burgrp/din-rs485-wifi/doc/BMS.Protocol.V2.5.CHINESE.pdf

# 监控平台与BMS通讯协议

# 版本信息

版本 | 日期 | 描述 | 作者
| V20191124 | 初稿
| V20200325 | 更新一些描述信息,更改0xA10改为0XD2,专用充电器开关指 令
| V20200325 | 确定传送的数据波特率115200
| V20200329 | 更新优化指令表，重新定义数据标识码
| V20200329 | 增加一次性读取全部数据指令.
| V20200427 | 进行写ID 写出厂日期进行说明
| V20200429 | 添加0xb7地址 软件版本号
| V20200429 | 对0x8b 0x8c 地址详细描述
| V20200508 | 对0x84地址进行优化 单位：0.1A修改成0.01A
| V20200512 | 0x81地址名称进行重新定义 电池箱内温度
| V20200512 | 把0xA0 0xA1 名称重新定义
| V20200512 | 对0x8B地址 报警位添加
| V20200526 | 添加重启系统标识0xBB
| V20200615 | 添加0xB8标识 版本变更 V2.0
V20200713 | 添加0xBC标识 恢复出厂初始化 版本变更 V2.1

添加309故障信息

| V20200825 | 添加0xBE 0xBF
V2.4 | 20201204 | 增加0xC0 重新定义电流字段数据 | echo
V2.5 | 20201217 | 增加必要字段上报说明 | echo

目录

1 概述
本规约定义了监控平台与电池终端之间的通讯协议，定义了报文格式和传输方式，通讯方式等。

## 2 引用标准

通信使用2G的GPRS中TCP传输, 4G中GAT1,SOCKET接口方式,RS232TTL串口,内容自定义通信格式,波特率115200.

## 3 网络拓扑

本协议是BMS,GPS,蓝牙端,PC上位机与终端点对点或总线的方式.

## 4 规约内容 4.1 通讯规则

通讯过程中设备有主动上报帧也有被动响应帧，具体参考通讯数据格式。每包数所间隔最少100MS,最长回复包不超过5S, 定时广播,如果休眠中,则于控制端发送激活信息,激活BMS,再进行通信.

## 4.2 帧格式

帧是传送信息的基本单元。其中包括起始符，长度，命令字，传输类型，信息域、结束标识，校验和。具体格式如表1 所示。数据单元中如果没有强制说明的内容低字节在右,高字节在左。发送是先发高位再发低位.
表1 帧格式
序号 | 帧单元 | 长度 | 备注
1 | STX | 2 | 起始帧：0x4E(78"N") 0x57(87"W")
2 | LENGTH | 2 | 帧长度
3 | BMS终端号 | 4 | 4字节ID
4 | 命令字 | 1 | 参考命令字说明,
5 | 帧来源 | 1 | 0.BMS,1.蓝牙,2.GPS,3,PC上位机
6 | 传输类型 | 1 | 0.读数据,1.应答帧 2.BMS主动上传
7 | 帧信息单元 | N | 信息域 BMS设置数据标识码
8 | 记录号 | 4 | 高1字节是随机码无意义(保留加密用)，低3字节是 记录序号
9 | 结束标识 | 1 | 0X68
10 | 校验和 | 4 | 累加校验和（高二字节用于CRC暂不启用填0，低二 字节用于累加校验）

## 4.2.1 帧起始符域

两个字节。第一个字节0x4e,第二个字节0x57。

## 4.2.2 长度域 L：两个字节，除去起始两个字符所有的数据字节包括校验和和长度域本身。

## 4.2.3 BMS终端号()

共四字节： FF FF FF FF 最高8位管理备用号，低24位是终端号 ，(最高一字节是保留默认00,低三字节是维一ID号)

## 4.2.4 命令字说明

一个字节，定义了本帧的传输功能。
命令码 | 命令项 | 备注
0x01 | 激活指令, | 当BMS休眠时,控制端要和BMS通信就要发先激活命令过来.收到 回复后再进行其它操作.
0X02 | 写指令

配置BMS参数指令,

0X03 | 读指令 | 读取BMS标识码数据,
0x05 | 对密码指令 | 要修改参数的时候,先发命令过正确之后才能改
0x06 | 读全部数据 | 一次性读完标识码表全部数据

## 4.2.5 帧来源说明

1个字节.相对于收发双方而言，0.BMS,1.蓝牙,2.GPS,3,PC上位机

## 4.2.6 传输类型

1个字节：0代表请求帧，1代表应答帧。2代表主动上报。 只要是先发起5-蓝牙,2-GPS,3-PC上位机，4-BMS先发起，回复都是用1。

## 4.2.7 记录号

## 高1个字节是随机码，低3个字节是记录码

## 4.2.8 结束码域

## 一个字节 0x68

## 4.2.9 校验码域

高二字节CRC16暂时不用,校验和从起始符到结束标识所有的数据累加和。

# 4.3 通讯数据格式 例： GPS读（全部、单个）数据参考

序号 | 帧单元 | 长度字节
1 | STX | 2 | 起始帧：0x4E(78"N") 0x57(87"W")
2 | LENGTH | 2 | 帧长度
3 | BMS终端号 | 4 | 4字节ID
4 | 命令字 | 1 | 参考命令写说明
5 | 帧来源 | 1 | 0.数据盒子,1.蓝牙,2.GPS,3,PC上位机
6 | 传输类型 | 1 | 0.读数据,1.应答帧 2.数据盒子主动上传
7 | 数据标识码 | 1 | 读单个数据参考(5.1表);读全部数据填0x00
8 | 记录号 | 4 | 高1字节是随机码无意义(保留加密用)，低3字节是记录序号
9 | 结束标识 | 1 | 0x68
10 | 校验和 | 4

BMS应答

序号 | 帧单元 | 长度

1

STX | 2 | 起始帧：0x4E(78"N") 0x57(87"W")

2 | LENGTH | 2
3 | 终端号 | 4
4 | 命令字 | 1
5 | 帧来源 | 1 | 0.数据盒子,1.蓝牙,2.GPS,3,PC上位机
6 | 传输类型 | 1 | 0.读数据,1.应答帧 2.数据盒子主动上传
7 | 标识码+数据 | 1+N 标识码+数据
8 | 记录号 | 4 | 高1字节是随机码无意义(保留加密用)，低3字节是记录序号
9 | 结束标识 | 1 | 0X68
10 | 校验和 | 4

# 例： GPS写数据参考

序号 | 帧单元 | 长度字节
1 | STX | 2 | 起始帧：0x4E(78"N") 0x57(87"W")
2 | LENGTH | 2 | 帧长度
3 | BMS终端号 | 4 | 4字节ID
4 | 命令字 | 1 | 参考命令写说明
5 | 帧来源 | 1 | 0.数据盒子,1.蓝牙,2.GPS,3,PC上位机
6 | 传输类型 | 1 | 0.读数据,1.应答帧 2.数据盒子主动上传
7 | 标识码+数据 | 1+N | 标识码+数据
8 | 记录号 | 4 | 高1字节是随机码无意义(保留加密用)，低3字节是记录序号
9 | 结束标识 | 1 | 0x68
10 | 校验和 | 4

BMS应答

序号 | 帧单元 | 长度
1 | STX | 2 | 起始帧：0x4E(78"N") 0x57(87"W")
2 | LENGTH | 2
3 | 终端号 | 4

4 | 命令字 | 1
5 | 帧来源 | 1 | 0.BMS,1.蓝牙,2.GPS,3,PC上位机
6 | 传输类型 | 1 | 0.读数据,1.应答帧 2.BMS主动上传
7 | 标识码 | 1 | 写单个数据参考(5.1表);
8 | 记录号 | 4 | 高1字节是随机码无意义(保留加密用)，低3字节是记录序号
9 | 结束标识 | 1 | 0X68
10 | 校验和 | 4

## 标志码注意：（读全部数据时后台数据标识码填0x00）

# 5.1 BMS设置数据标识码

使用 指令 | 数 据 标 识码 | 名称 | 字节 | 类型
R | 0x79 | 单 节 电 池 电 压 | 3*n | HEX | 前一 个 字 节 是 电 池 号 ， 后 面 一 个 是 电 压值 MV,当 读 取 全 部 数 据 时 ,0x79后 如 面 跟 一 个 字 节 长 度 数 据 ,然 后 每 三 个 字 节 一 组 表 示电 池 电 压 .
R | 0x80 | 读 功 率 管 温 度 | 2 | HEX | 0--140（ -40至 100℃） 超过 100部分 是 负 温 度 ,如 10 1是负 1度（ 100 基 准 ）
R | 0x81 | 读 电 池 箱 内 温度 | 2 | HEX | 0--140（ -40至 100℃） 超过 100部分 是 负 温 度 ,同上（ 100基 准 ）
R | 0x82 | 读 电池 温度 | 2 | HEX | 0--140（ -40至 100℃） 超过 100部分 是 负 温 度 ,同上（ 100基 准 ）
R | 0X83 | 电 池 总 电 压 | 2 | HEX | 0.01V 3500*0.01=35.0 0v 最 小 单 位 10MV
R | 0X84 | 电 流 数 据 | 2 | Hex | 10000 (10000-11000)*0.01=-10.00a(放电） （10000-9500）*0.01=5.00a(充电 ) 精度 10MA 单 位 ： 0.01A 注 ： C0:0x01 重 新定义 0x84 电 流 数 据 ， 单位 10MA， 最高位 为 0 表 示 放 电 ，为 1 表 示 充 电 如 放电 20A，则 传 输 数 据 为 2000 (0x07D0) 如 充 电 20A， 则 传 输 数 据 为 34768(0x87D0)
R | 0X85 | 电 池 剩 余 容 量 | 1 | HEX | SOC， 0-100%,
R | 0X86 | 电 池 温 度 传 感 器 数 量 | 1 | Hex | 二 个 电 池 温 度 传 感 器 ,
R | 0X87 | 电 池 使 用 循 环 次 数 | 2 | Hex
R | 0X89 | 电 池 循 环 总 容 量 | 4 | HEX | 安时
R | 0x8a | 电 池 总 串 数 | 2 | HEX

R | 0X8b | 电 池 警 告 信 息 | 2 | hex
0位： 低 容 量 报 警 | 1报警 0正常 .只 警 告
1位： MOS管 超温 报警 | 1报警 0正 常 ， 报警
2位： 充 电 过 压 报 警 | 1报警 0正常， 报警
3位： 放 电 欠 压 报 警 | 1报警 0正常， 报警
4位： 电 池 超 温 报 警 | 1报警 0正常， 报警
5位： 充 电 过 流 报 警 | 1报警 0正常 ,报警
6位： 放 电 过 流 报 警 | 1报警 0正常， 报警
7位： 电 芯 压 差 报 警 | 1报警 0正 常 ， 报警
8位： 电 池 箱 内 超 温 报 警 1报警 0正 常 ， 报警
9位： 电 池 低 温 报 警 | 1报警 0正 常 ， 报警
10位 ： 单 体 过 压 报 警 | 1报警 0正 常 ， 报警
11位 ： 单 体 欠 压 报 警 | 1报警 0正 常 ， 报警
12位 ： 309_A保护 | 1报警 0正 常 ， 报警
13位： 309_B保护 | 1报警 0正 常 ， 报警

14位 ： 保 留
15位 ： 保 留

例：
0x0001:表 示 低 容 量 报 警 值
0x0001 ----> 低 容 量 报 警
功 率 板 超 温 报 警
R | 0X8c | 电 池 状 态 信 息 | 2 | | 0位 充电 MOS管状态 1开 0关 这 个 是 上 传 提 示 用 的 1位 放电 MOS管状态 1开 0关 这个 是 上 传 提 示 用 的 。 2位 均 衡 开 关 状 态 1开 ,0关 这 个 是 上 传 提 示 用 的 3位 电 池 掉 线 1正常 .0掉线 ， 这 个 是 上 传 提 示 ， 4-15位 ： 保 留 例： 00 01： 表 示 充 电 MOS管 打 开
RW | 0x8e | 总 电 压 过 压 保 护 | 2 | HEX | 1000-15000 (10 MV)最 小 单 位 10MV
RW | 0x8f | 总 电 压 欠 压 保 护 | 2 | HEX | 1000-15000 (10 MV)最 小 单 位 10MV
RW | 0X90 | 单 体 过 压 保 护 电 压 | 2 | Hex | 1000--4500 MV,
RW | 0x91 | 单 体 过 压 恢 复 电 压 | 2 | HEX | 1000-4500MV
RW | 0x92 | 单 体 过 压 保 护 延 时 | 2 | HEX | 1-60秒
RW | 0x93 | 单 体 欠 压 保 护 电 压 | 2 | Hex | 1000--4500 MV
RW | 0x94 | 单 体 欠 压 恢 复 电 压 | 2 | HEX | 1000-4500MV
RW | 0x95 | 单 体 欠 压 保 护 延 时 | 2 | HEX | 1-60S秒
RW | 0x96 | 电 芯 压 差 保 护 值 | 2 | Hex | 0-1000MV
RW | 0x97 | 放 电 过 流 保 护 值 | 2 | Hex | 1-1000A
RW | 0x98 | 放 电 过 流 延 时 | 2 | Hex | 1-60S 秒
RW | 0x99 | 充 电 过 流 保 护 值 | 2 | Hex | 1-1000A
RW | 0x9a | 充 电 过 流 延 时 | 2 | HEX | 1-60S
RW | 0x9b | 均 衡 启 动 电压 | 2 | Hex | 2000-4500MV

RW | 0x9c | 均 衡 开 启 压 差 | 2 | hex | 10-1000 MV，
RW | 0x9d | 主动 均 衡 开 关 | 1 | Hex | 0关 or 1开
RW | 0x9e | 功 率 管 温 度 保 护 值 | 2 | Hex | 0--100℃
RW | 0x9f | 功 率 管 温 度 恢 复 值 | 2 | Hex | 0-100℃
RW | 0xa0 | 电 池 箱 内 温 度 保 护 值 | 2 | Hex | 40--100℃，
RW | 0xa1 | 电 池 箱 内 温 度 恢 复 值 | 2 | Hex | 40--100℃
RW | 0xa2 | 电 池 温 差 保 护 值 | 2 | Hex | 5-20℃ ,
RW | 0xa3 | 电 池 充 电 高 温 保 护 值 | 2 | HEX | 0-100℃
RW | 0xa4 | 电 池 放 电 高 温 保 护 值 | 2 | HEX | 0-100℃
RW | 0xa5 | 充 电 低 温 保 护 值 | 2 | Hex | -45℃ /+25℃ （ 没 有 基 准 -有 符 号 数 据 ）
RW | 0xa6 | 充 电 低 温 保 护 恢 复 值 | 2 | Hex | -45℃ /+25℃ （ 没 有 基 准 -有 符 号 数 据 ）
RW | 0xa7 | 放 电 低 温 保 护 值 | 2 | Hex | -45℃ /+25℃ （ 没 有 基 准 -有 符 号 数 据 ）
RW | 0xa8 | 放 电 低 温 保 护 恢 复 值 | 2 | Hex | -45℃ /+25℃ （ 没 有 基 准 -有 符 号 数 据 ）
RW | 0xa9 | 电 池 串 数 设 置 | 1 | Hex | 3-32
RW | 0xaa | 电 池 容 量 设 置 | 4 | Hex | AH (安时 )
RW | 0xab | 充电 MOS管 开 关 | 1 | Hex | 0关闭 1打开
RW | 0xac | 放电 MOS管 开 关 | 1 | Hex | 0关闭 1打开
RW | 0xad | 电 流校准 | 2 | Hex | 100MA-20000MA
RW | 0xae | 保 护 板 地 址 | 1 | Hex | 这 个 地 保 留 ， 级 联 的 时 候 使 用 ，
RW | 0xaf | 电 池 类 型 | 1 | HEX | 0： 磷 酸 铁 锂 ， 1： 三 元 ， 2： 钛 酸 锂
RW | 0xb0 | 休 眠 等 待 时 间 | 2 | Hex | 秒 数 据 ， 暂 时 作 参 考 ，
RW | 0xb1 | 低 容 量 报 警 值 | 1 | Hex | 0--80%
RW | 0xb2 | 修 改 参 数 密 码 | 10 | hex | 暂 时 作 参 考 ,固 定 一 个 密 码 ，
RW | 0xb3 | 专 用 充 电 器 开 关 | 1 | Hex | 0关 or 1开
RW | 0Xb4 | 设备 ID码 | 8 | 字符 | 例 60300001（ 60-标 称 电 压 等 级 ： 按 电 压 的 等 级 定 义 比如 60为 60V 系列 48为 48V系 列 ；3 -材 料 体 系 ：按 电 池 材 料 的 体 系 定 义 比 如 铁 锂 代 号 为 1 锰 酸 代 号 2 三 元 代 号 3； 00001-生 产 流 水 号 ： 根 据 制 造 厂 家 生 产 厂 家 当 月 生 产 的 该 型 号 的第 N组 ， 则 编 号 为 N（ 例 ： 某 型 号 的 第 1组 ， 则 N为 00001） ） 字 符
RW | 0Xb5 | 出 厂 日 期 | ４ | 字符 | 例 2004-生 产 年 份 ： 按 实 际 生 产 年 份 取 后 两 位 数 ； 列 2020年生产的 电 池 ， 年 份 代 号 20； 生 产 月 份 ： 01--12 月份； 字符

RW | 0xb6 | 系 统 工 作 时 间 | 4 | HEX | 出 厂 时 清 零 ， 单 位 分
R | 0xb7 | 软 件 版 本 号 | 15 | 字符 | NW_1_0_0_200428
RW | 0xb8 | 是 否 启 动 电 流 校 准 | 1 | HEX | 1： 启 动 校 准 0： 关 闭 校 准
RW | 0xb9 | 电 池 实 际 容 量 | 4 | HEX | AH (安时 )
RW | 0xBA | 厂家 ID命名 | 24 | 字符 | 列： "BT3072020120000200521001" *产 品 名 称 ： 电 池 用 BT *材 料 体 系 ： 铁 锂 代 号 1;锰 酸 代 号 2; 三 元 代 号 3 *电 压 等 级 ： 48V系 列 用 4 8;60V系 列 用 60 72V系 列 用 72 *容 量 等 级 ： 20AH规 格 用 20 *循 环 寿 命 ： 400次 循 环 使 用 04标记 ,1200次 循 环 用 12标记 *厂家代码：低速车电池生产厂家英文代码，若厂家英文 代 码 不 足 四 位 ， 以 字 符 0补位 *生 产 年 份 ： 按 实 际 生 产 年 份 取 后 两 位 数 ;列 2019年生产的电池 年 份 代 号 “ 19” *生 产 月 份 ： 1—— 12月份 *生 产 日 期 ： 01-31 *生产流水号：根据制造厂家生产日期当天生产的该型号第 N组， 则 编 号 为 N(例 ： 某 型 号 的 第 一 组 ， 则 为 001)
W | 0xBB | 重 启 系 统 | 1 | HEX | 1： 重 启 系 统
W | 0xBC | 恢 复 出 厂 设 置 | 1 | HeX | 1： 恢 复 （ 只 恢 复 出 厂 时的 基 准 参 数 ）
W | 0xBD | 远 程 升 级 标 识 | 1 | HeX | 1 开始 （ 下 发 文 件 时 等 标 识 回 复 ）
W | 0xBE | 电 芯 低 压 关 闭 GPS | 2 | Hex | 单位 ： mv（ 检 测 到 低 压 时 关 闭 给 GPS的 电 源 ）
W | 0xBF | 电 芯 低 压 恢 复 GPS | 2 | Hex | 单位 : mv (检 测 到 恢 复 电 压 值 时 打 开 给 GPS的电源 )
R | 0xC0 | 协 议 版 本 号 | 1 | Hex | 默 认 值 :0x00 0x01: 重 新 定 义 0x84电 流 数 据 ， 单位 10MA， 最高位 为 0表 示 放 电 ， 为 1表 示 充 电 如 放 电 20A， 则 传 输 数 据 为 2000 (0x07D0) 如 充 电 20A， 则 传 输 数 据 为 34768(0x87D0)

【注】
1. 0x79 ~ 0xb9 所有字段中，标记了R或RW都应上报，对于已出货的旧版本没有上报的，尽量升级；如不便升级的话，请联 系我们的技术支持，电话：13755639263/13480924112
2. 0xBA 厂家ID命名，此字段主要用于换电柜使用，如有换电柜的需求，必须加上该字段。
