burgrp/din-rs485-wifi/board/bleriot-rs485.kicad_pcb

## KiCad design board/bleriot-rs485.kicad_pcb (2026-08-22)

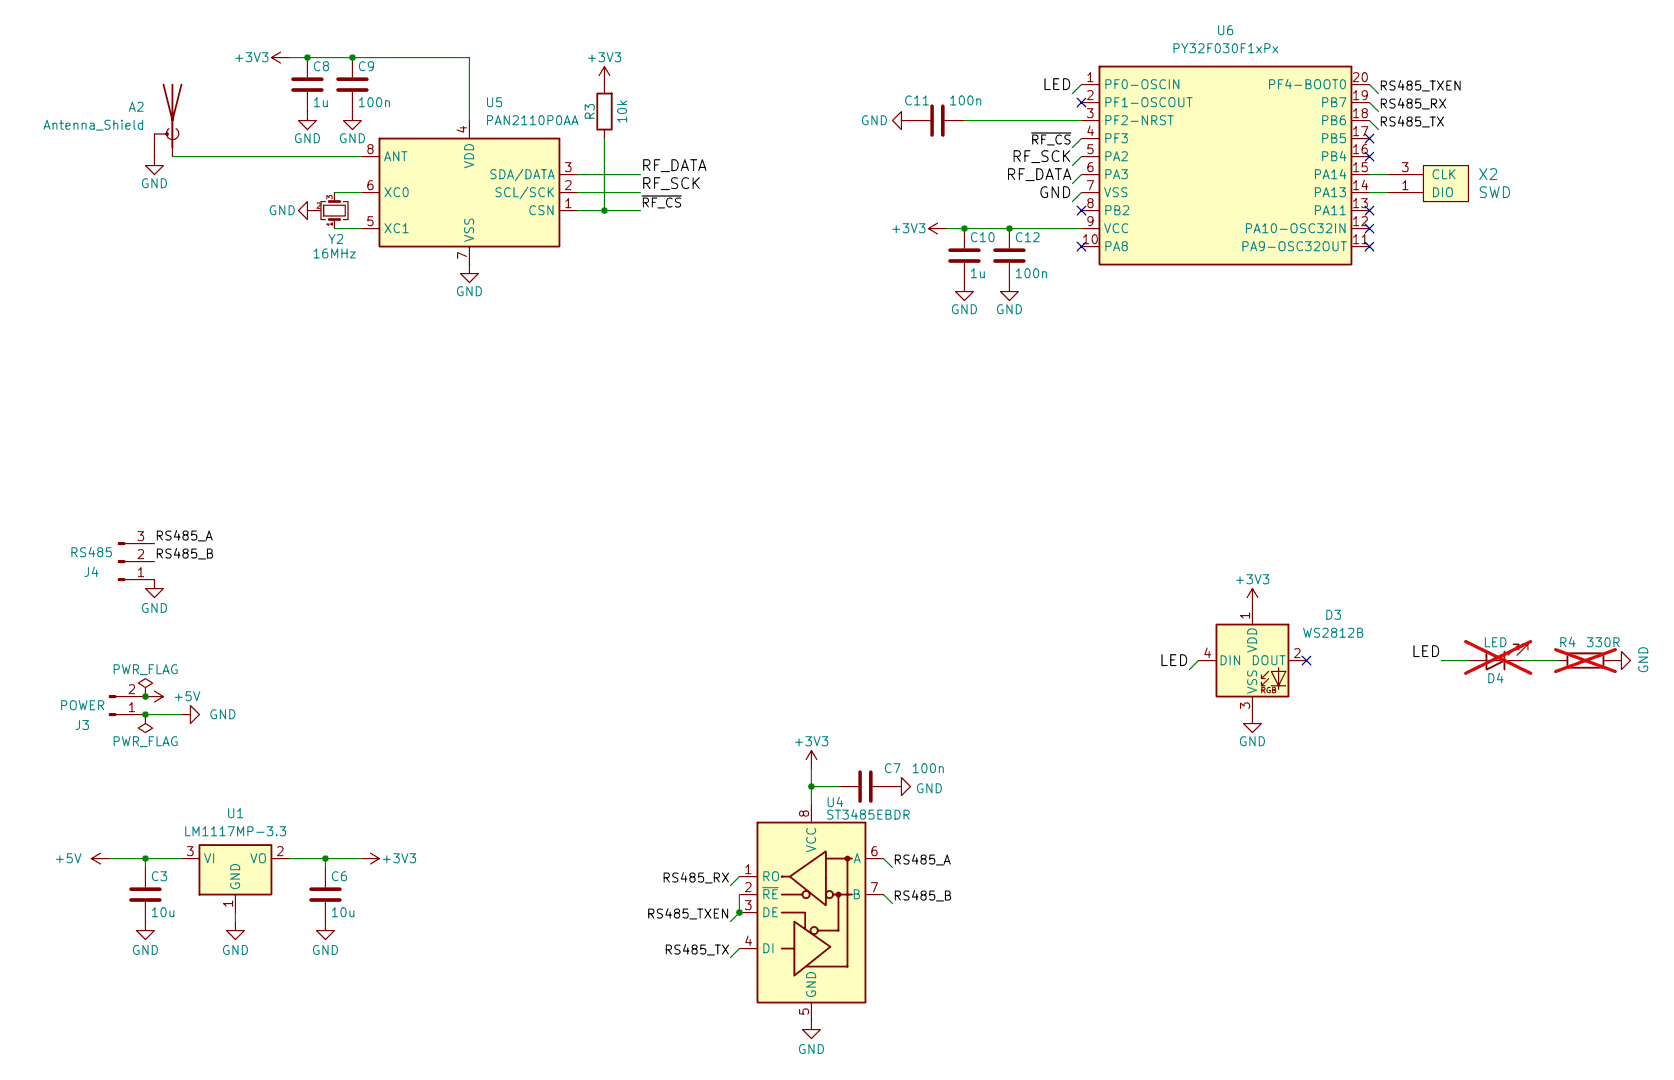
[picture p1: schematic bleriot-rs485.kicad_sch]

Parts:
A2: Antenna_Shield; Texas_SWRA117D_2.4GHz_Right
C3, C6: 10u; C_0805_2012Metric
C7, C9, C11, C12: 100n; C_0805_2012Metric
C8, C10: 1u; C_0805_2012Metric
D3: WS2812B; LED_WS2812B_PLCC4_5.0x5.0mm_P3.2mm
D4: LED; LED_0805_2012Metric_Pad1.15x1.40mm_HandSolder; not fitted
J3: POWER; PhoenixContact_MC_1,5_2-G-3.5_1x02_P3.50mm_Horizontal
J4: RS485; PhoenixContact_MC_1,5_3-G-3.5_1x03_P3.50mm_Horizontal
R3: 10k; R_0805_2012Metric
R4: 330R; R_0805_2012Metric; not fitted
U1: LM1117MP-3.3; SOT-223-3_TabPin2
U4: ST3485EBDR; SOIC-8_3.9x4.9mm_P1.27mm
U5: PAN2110P0AA; SOIC-8_3.9x4.9mm_P1.27mm
U6: PY32F030F1xPx; TSSOP-20_4.4x6.5mm_P0.65mm
X2: SWD
Y2: 16MHz; Crystal_SMD_3225-4Pin_3.2x2.5mm

Connections:
+3V3: C6.1, C7.1, C8.1, C9.1, C10.1, C12.1, D3.1 (VDD), R3.2, U1.2 (VO), U4.8 (VCC), U5.4 (VDD), U6.9 (VCC)
+5V: C3.1, J3.2, U1.3 (VI)
/LED: D3.4 (DIN), D4.2 (A), U6.1 (PF0-OSCIN)
/RF_DATA: U5.3 (SDA/DATA), U6.6 (PA3)
/RF_SCK: U5.2 (SCL/SCK), U6.5 (PA2)
/RS485_A: J4.3, U4.6 (A)
/RS485_B: J4.2, U4.7 (B)
/RS485_RX: U4.1 (RO), U6.19 (PB7)
/RS485_TX: U4.4 (DI), U6.18 (PB6)
/RS485_TXEN: U4.2 (~RE), U4.3 (DE), U6.20 (PF4-BOOT0)
/~RF_CS: R3.1, U5.1 (CSN), U6.4 (PF3)
GND: A2.2 (Shield), C3.2, C6.2, C7.2, C8.2, C9.2, C10.2, C11.2, C12.2, D3.3 (VSS), J3.1, J4.1, R4.1, U1.1 (GND), U4.5 (GND), U5.7 (VSS), U6.7 (VSS), X2.2 (GND), Y2.2 (G), Y2.4 (G)
unnamed: A2.1 (A), U5.8 (ANT)
unnamed: D4.1 (K), R4.2
unnamed: U5.6 (XC0), Y2.3
unnamed: U5.5 (XC1), Y2.1
unnamed: U6.14 (PA13), X2.1 (DIO)
unnamed: U6.15 (PA14), X2.3 (CLK)
unnamed: C11.1, U6.3 (PF2-NRST)

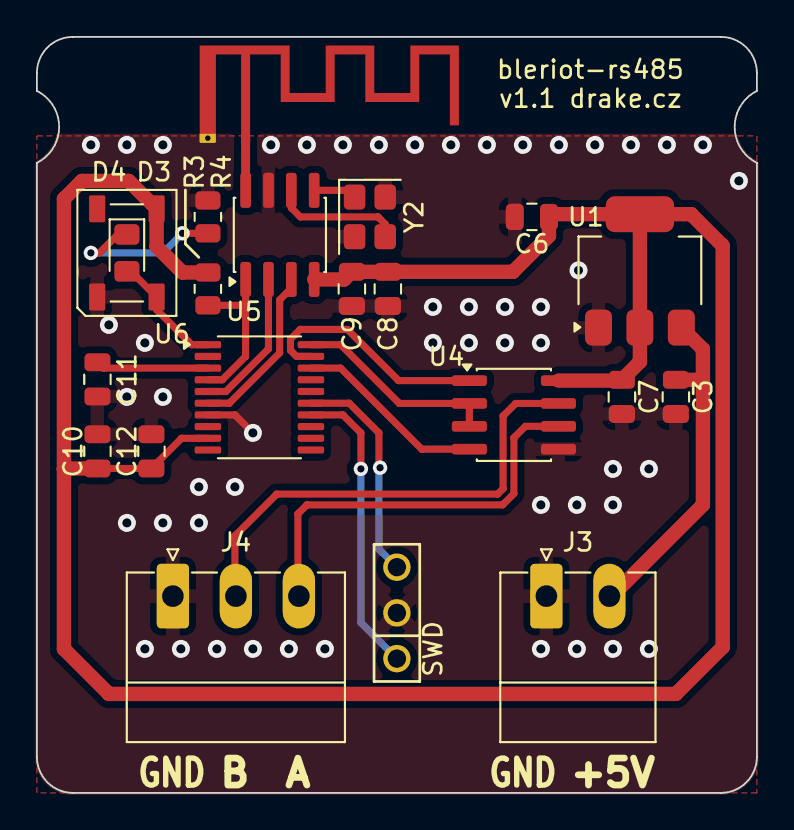
[picture p2: board bleriot-rs485.kicad_pcb from above]

Board: 2 copper layers, 40.0 x 42.0 mm, 21 parts (0 on the bottom side), 19 nets.
