burgrp/din-rs485-wifi/vertical/vertical.kicad_pcb

## KiCad design vertical/vertical.kicad_pcb (2026-06-17)

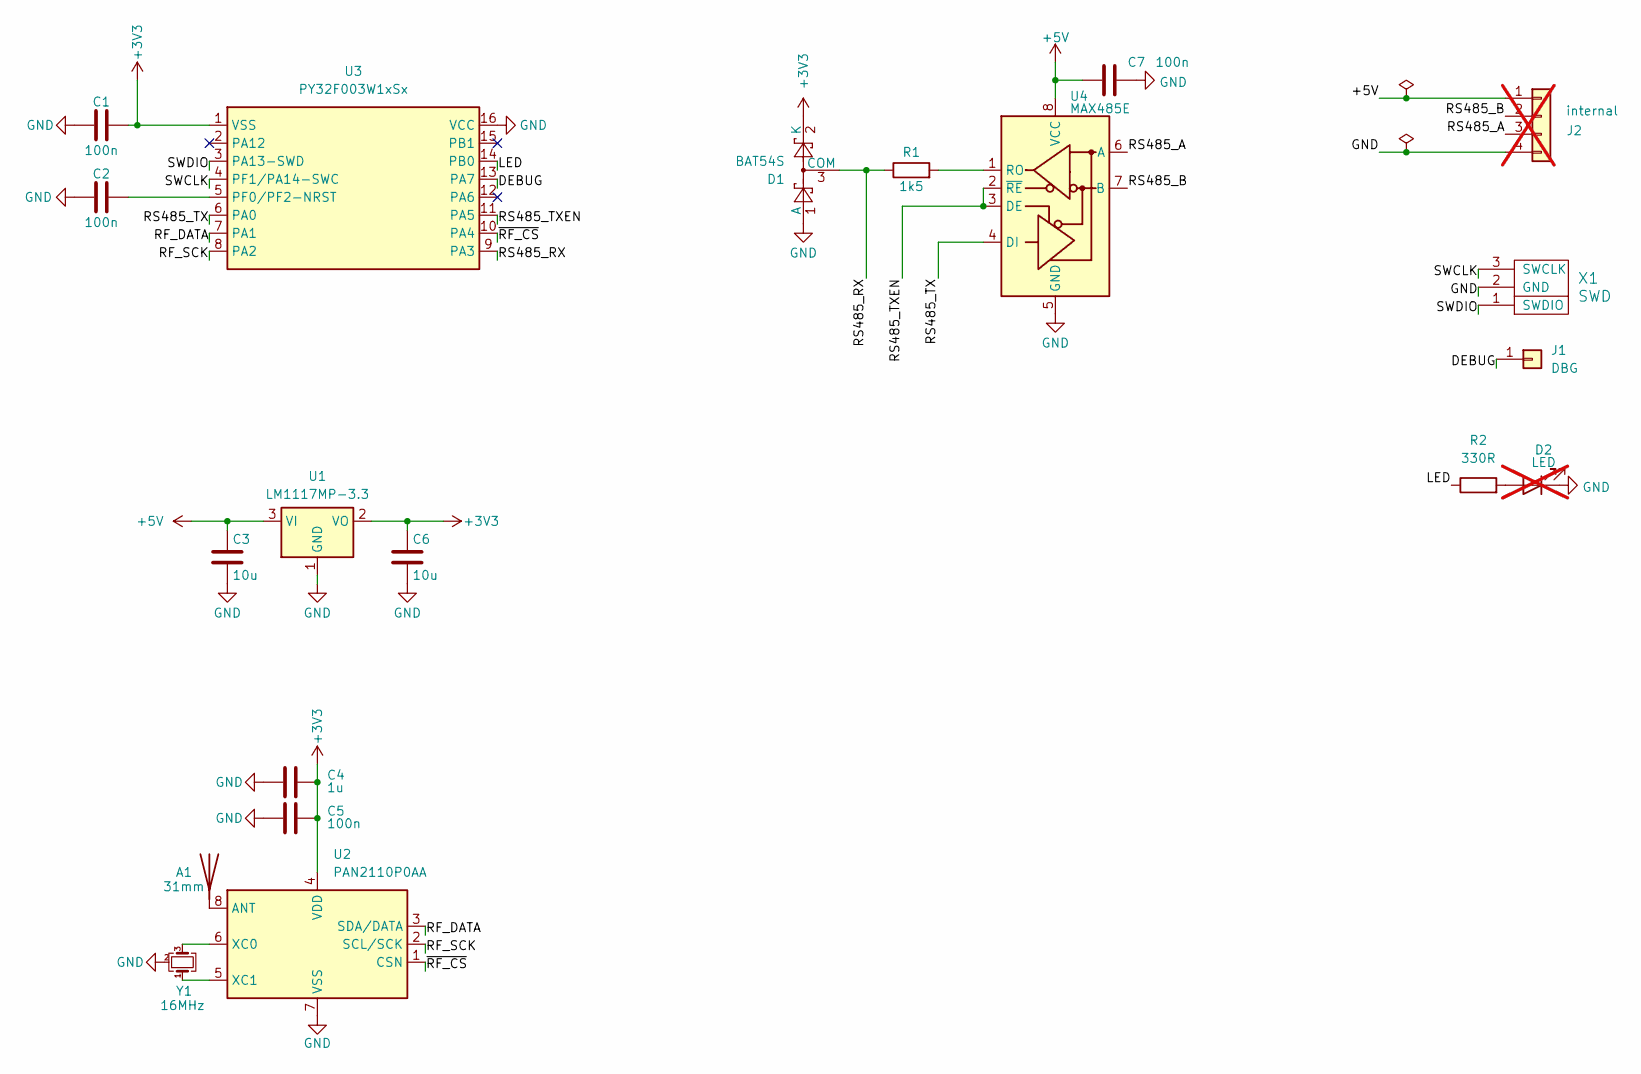
[picture p3: schematic vertical.kicad_sch]

Parts:
A1: 31mm; Wire antena 2.4GHz
C1, C2, C5, C7: 100n; C_0805_2012Metric
C3, C6: 10u; C_0805_2012Metric
C4: 1u; C_0805_2012Metric
D1: BAT54S; SOT-23
D2: LED; LED_2010_5025Metric; not fitted
J1: DBG; PinHeader_1x01_P2.54mm_Vertical
J2: internal; PinHeader_1x04_P2.54mm_Horizontal; not fitted
R1: 1k5; R_0805_2012Metric
R2: 330R; R_0805_2012Metric
U1: LM1117MP-3.3; SOT-223-3_TabPin2
U2: PAN2110P0AA; SOIC-8_3.9x4.9mm_P1.27mm
U3: PY32F003W1xSx; SOIC-16_3.9x9.9mm_P1.27mm
U4: MAX485E; SOIC-8_3.9x4.9mm_P1.27mm
X1: SWD
Y1: 16MHz; Crystal_SMD_3225-4Pin_3.2x2.5mm

Connections:
+3V3: C1.1, C4.1, C5.1, C6.1, D1.2 (K), U1.2 (VO), U2.4 (VDD), U3.1 (VSS)
+5V: C3.1, C7.1, J2.1, U1.3 (VI), U4.8 (VCC)
/DEBUG: J1.1, U3.13 (PA7)
/LED: R2.1, U3.14 (PB0)
/RF_DATA: U2.3 (SDA/DATA), U3.7 (PA1)
/RF_SCK: U2.2 (SCL/SCK), U3.8 (PA2)
/RS485_A: J2.3, U4.6 (A)
/RS485_B: J2.2, U4.7 (B)
/RS485_RX: D1.3 (COM), R1.1, U3.9 (PA3)
/RS485_TX: U3.6 (PA0), U4.4 (DI)
/RS485_TXEN: U3.11 (PA5), U4.2 (~RE), U4.3 (DE)
/SWCLK: U3.4 (PF1/PA14-SWC), X1.3 (SWCLK)
/SWDIO: U3.3 (PA13-SWD), X1.1 (SWDIO)
/~RF_CS: U2.1 (CSN), U3.10 (PA4)
GND: C1.2, C2.2, C3.2, C4.2, C5.2, C6.2, C7.2, D1.1 (A), D2.1 (K), J2.4, U1.1 (GND), U2.7 (VSS), U3.16 (VCC), U4.5 (GND), X1.2 (GND), Y1.2 (G), Y1.4 (G)
unnamed: A1.1 (A), U2.8 (ANT)
unnamed: D2.2 (A), R2.2
unnamed: U2.6 (XC0), Y1.3
unnamed: U2.5 (XC1), Y1.1
unnamed: C2.1, U3.5 (PF0/PF2-NRST)
unnamed: R1.2, U4.1 (RO)

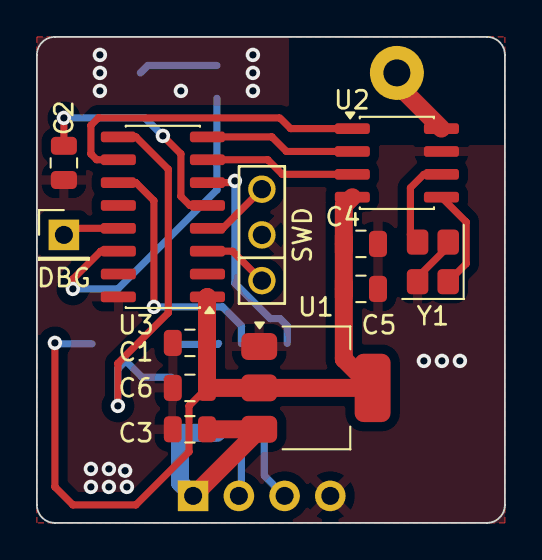
[picture p4: board vertical.kicad_pcb from above]

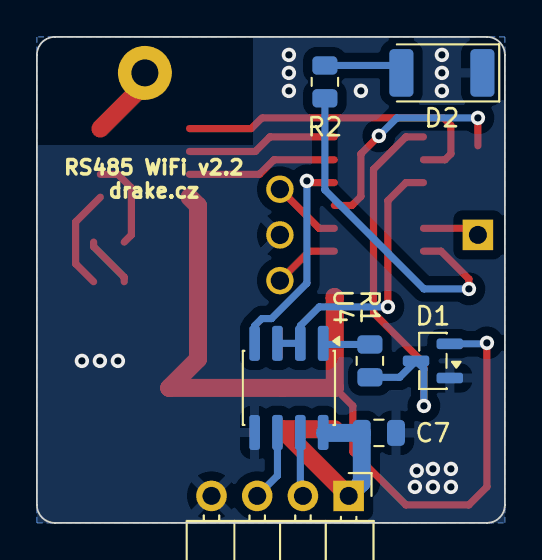
[picture p5: board vertical.kicad_pcb from below]

Board: 2 copper layers, 26.0 x 27.0 mm, 20 parts (7 on the bottom side), 21 nets.
