burgrp/din-rs485-wifi/(commit log)

2024-11-14 board update
    [bom.csv, designators.csv, positions.csv, vertical.kicad_pcb, vertical.kicad_sch]
2025-05-23 Update UART timeout character for improved communication stability
    [main.py]
2026-06-17 Update KiCad design files
    [vertical.kicad_pcb, vertical.kicad_sch]
2026-07-09 feat: add Modbus register definitions and device configuration for din-rs485 bridge
    - Introduced sinotimer3p.go to define grid and house registers with associated tags, names, titles, units, addresses, and scaling factors.
    - Created types.go to define configuration structures, register definitions, and device types for the din-rs485 bridge.
    - Implemented test-hub.go to initialize the din-rs485 device with its configuration and register definitions.
2026-07-09 feat: refactor device configuration and register handling for improved modularity
2026-07-09 refactor: streamline device configuration and register handling for RS485 bridge
2026-07-10 feat: generic config-driven RS485 bridge with mixed device-type support
    Encode the RS485 slave selector and Modbus word address into the 16-bit
    BleRiot wire tag (tag = sel<<12 | addr), removing all meter semantics from
    the firmware. The device now polls only the addresses named in its
    provisioning Config and notifies encoded tags; names, titles, units, and
    scales live only on the hub.
    Config packs a shared run pool: each slave references a slice of it via a
    Span byte, so identical devices share pool space and different Modbus
    device types can coexist on one node. Runs are packed uint16 (addr<<4 |
    count), keeping the fixed-size payload at 28 bytes to fit the 64-byte
    PY32 flash page.
    - spec/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
2026-07-10 refactor: extract RS485 Modbus-RTU client into reusable rs485 package
    Move the UART-based Modbus master out of package main into a standalone,
    board-agnostic package (fw/rs485). Wiring, baud and frame timing are now
    supplied through rs485.Config instead of relying on main's pin constants,
    so the client can be reused by other firmware.
    - add fw/rs485/client.go (tinygo): rs485.Client + rs485.Config, New()
    - main.go wires the client via rs485.New(rs485.Config{...})
    - drop the old fw/rs485_client_tinygo.go and unused noopClient stub
    - no non-tinygo stub is needed: nothing on the host imports the package
    - fix a stale "Sel" reference in spec/config.go doc comment
2026-07-10 refactor: update pin mappings and client initialization in main firmware
2026-07-14 fw: split RS485 bridge into per-device meter/bms firmwares
    Replace the single flat firmware with a shared rig plus separate meter and
    bms binaries, each compiling in its own register table (meterdev/bmsdev) and
    reducing it to a hub-visible device type via spec. Add the nwbms JK-BMS
    protocol driver, the uartline RS485 line helper, and the rig node runtime.
    Move RS485 onto USART2 (PA2/PA3) and use USART1 for the --serial uart debug
    console, and offset Modbus addresses into non-zero RF tags so voltage.1 at
    address 0 no longer collides with the reserved tag 0.
2026-07-14 fw: retarget rig pin map to the vertical PY32F003 board (untested)
    Switch the rig pin mapping from the BOB dev board to the production vertical
    board (PY32F003W1xSx, SOP16), per vertical.kicad_sch:
    RS485 TX PA0 (USART2_TX, AF9) RS485 RX PA3 (USART2_RX, AF4)
    RS485 DE PA5 debug TX PA7 (USART1_TX, AF8)
    RF SCK/DATA/CS PA2/PA1/PA4 LED PB0
    PA0 only exposes USART2_TX on AF9 while PA3 uses AF4, so split the single
    uartline AltFunc into TxAltFunc/RxAltFunc. Remove all BOB references.
    NOT YET TESTED ON HARDWARE: the first vertical PCB has VCC/VSS swapped on
    the MCU and must be respun before this can be flashed and verified. Builds
    clean for py32f003_32k_4k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
2026-08-02 dir layout
    [bleriot-rs485.kicad_pcb, bleriot-rs485.kicad_sch, horizontal.kicad_pcb, horizontal.kicad_sch]
2026-08-22 board fixes
    [bleriot-rs485.kicad_pcb, bleriot-rs485.kicad_sch]
2026-08-22 update .gitignore to remove 'production' and add board-specific entries
2026-08-23 add documentation for three phase four wire din-rail energy meter
2026-08-23 Remove deprecated nwbms and rig packages, along with associated tests and configurations
    - Deleted the nwbms package which included client, decode, frame, tags, and test files.
    - Removed the rig package that implemented the node runtime for DIN RS485 boards.
    - Eliminated the uartline package which provided a half-duplex serial transport over RS485.
    - Cleared out the rs485 package that implemented a Modbus-RTU master.
    - Removed the spec package that held hardware-facing facts and provisioning configurations.
    - Deleted the test-hub file that served as the site/hub binary for RS485 nodes.
2026-08-23 Add BleRiot RS485 energy-meter firmware
    - Introduced a new firmware for a three-phase DIN-rail energy meter using the BleRiot RS485 board.
    - Added a Makefile for build, flash, and disassembly commands.
    - Implemented Modbus communication for reading measurements from the energy meter.
    - Created a device type specification for the energy meter with defined registers and their metadata.
    - Added tests for Modbus client functionality and decoding of float32 values.
    - Included a README with build instructions and protocol details.
    - Configured the project with Go modules for dependency management.
